jvedder/diff-probe/README.md

# Diff-Probe
A KiCAD PCB project for a differential scope probe.
 * 3db Bandwidth over 100 MHz (per LTspice)
 * Attenuation is 1:10 (that is, a '10x' probe)
 * Input range +72 V to -100 V 
 * Differential input range ±40 V for ±4 V output to scope
 * Power supply ±5 V

MIT License
