jvedder/diff-probe/diff-probe-bom.xlsx

Sheet: License
MIT License
Copyright (c) 2023 John Vedder
Permission is hereby granted, free of charge, to any person obtaining a copy
of this hardware, software, and associated documentation files (the "Product"),
to deal in the Product without restriction, including without limitation the
rights to use, copy, modify, merge, publish, distribute, sublicense, and/or
sell copies of the Product, and to permit persons to whom the Product is
furnished to do so, subject to the following conditions:
The above copyright notice and this permission notice shall be included in all
copies or substantial portions of the Product.
THE PRODUCT IS PROVIDED "AS IS", WITHOUT WARRANTY OF ANY KIND, EXPRESS OR
IMPLIED, INCLUDING BUT NOT LIMITED TO THE WARRANTIES OF MERCHANTABILITY,
FITNESS FOR A PARTICULAR PURPOSE AND NONINFRINGEMENT. IN NO EVENT SHALL THE
AUTHORS OR COPYRIGHT HOLDERS BE LIABLE FOR ANY CLAIM, DAMAGES OR OTHER
LIABILITY, WHETHER IN AN ACTION OF CONTRACT, TORT OR OTHERWISE, ARISING FROM,
OUT OF OR IN CONNECTION WITH THE PRODUCT OR THE USE OR OTHER DEALINGS IN THE
PRODUCT.

Sheet: diff-probe-bom
Differential Probe, 100MHz, ±40V
PCB 102 Rev A
MIT License
Ref Des | Qty | Value | Digikey PN | Buy? | Vendor | Vendor PN | Description | Cost Ea | Footprint
PCB | 1 | PCB | 3237-PCB_BARE_BOARD-ND | Y | Digi-key | PCB102_RevA | Printed Circuit Board via DKred | $5.140
C1, C3, | 2 | 3.3pF | 478-KGQ15ACG2D3R3BTCT-ND | Y | KYOCERA AVX | KGQ15ACG2D3R3BT | CAP CER 3.3PF ±0.1pF 200V NP0 0603 | $0.233 | Capacitor_SMD:C_0603_1608Metric
C2, C4, | 2 | 68pF | 478-KGQ15ACG2A680FTCT-ND | Y | KYOCERA AVX | KGQ15ACG2A680FT | CAP CER 68PF 100V NP0 0603 | $0.227 | Capacitor_SMD:C_0603_1608Metric
C5, C6, | 4 | 6.8pF | 478-KGQ15ACG2D6R8BTCT-ND | Y | KYOCERA AVX | KGQ15ACG2D6R8BT | CAP CER 6.8PF ±0.1pF 200V NP0 0603 | $0.321 | Capacitor_SMD:C_0603_1608Metric
C10, C11, C20, C21, C30, C31, | 6 | 1nF | 399-1082-1-ND | N | Kemet | C0603C102K5RACTU | CAP CER 1,000pF (1nF) 50V X7R 0603 | $0.032 | Capacitor_SMD:C_0603_1608Metric
C12, C13, C22, C23, C32, C33, | 6 | 10nF | 399-1091-1-ND | N | Kemet | C0603C103K5RACTU | CAP CER 10,000PF (10nF) 50V X7R 0603 | $0.038 | Capacitor_SMD:C_0603_1608Metric
C40, C41, | 2 | 1uF | 399-8147-1-ND | N | Kemet | C1206C105K5RACTU | CAP CER 1UF 50V X7R 1206 | $0.127 | Capacitor_SMD:C_1206_3216Metric
D1, D2, | 2 | BAT54W | BAT54WT1GOSCT-ND | Y | onsemi | BAT54WT1G | Schottky barrier diode, SOT-323 | $0.197 | Package_TO_SOT_SMD:SOT-323_SC-70_Handsoldering
D20, D21, | 2 | LED | 160-1435-1-ND | Y | Lite-on | LTST-C190KGKT | LED GREEN CLEAR CHIP SMD 0603 | $0.200 | Diode_SMD:D_0603_1608Metric
J1, | 1 | Conn_01x02 | 2057-PH1RB-02-UA-ND | Y | Adam Tech | Conn_01x02 | CONN HEADER R/A 2POS 2.54MM | $0.065 | Library:PinHeader_1x02_P2.54mm_Vertical
J2, | 1 | Conn_Coaxial | WM4089-ND | N | Molex | 73100-0167 | CONN BNC RCPT R/A 50 OHM PCB | $2.580 | Library:BNC_Molex_73100-0167_Horizontal
J3, | 1 | Conn_01x03 | 2057-PH1RB-03-UA-ND | Y | Adam Tech | PH1RB-03-UA | CONN HEADER R/A 3POS 2.54MM | $0.097 | Library:PinHeader_1x03_P2.54mm_Horizontal
R1, R3, | 2 | 191K 0.1% | YAG1553CT-ND | Y | YAGEO | RT0603BRD07191KL | RES SMD 191K OHM 0.1% 1/10W 0603 | $0.288 | Resistor_SMD:R_0603_1608Metric
R2, R4, | 2 | 10.0K 0.1% | YAG4438CT-ND | Y | YAGEO | RT0603BRB0710KL | RES SMD 10K OHM 0.1% 1/10W 0603 | $0.464 | Resistor_SMD:R_0603_1608Metric
R5, R7, | 2 | 1K 0.1% | YAG2179CT-ND | Y | YAGEO | RT0603BRB071KL | RES SMD 1K OHM 0.1% 1/10W 0603 | $0.464 | Resistor_SMD:R_0603_1608Metric
R6, | 1 | 2K 0.1% | YAG2183CT-ND | Y | YAGEO | RT0603BRB072KL | RES SMD 2K OHM 0.1% 1/10W 0603 | $0.468 | Resistor_SMD:R_0603_1608Metric
R8, R9, R10, R11, | 4 | 500 0.1% | 13-RT0603BRC07500RLCT-ND | Y | YAGEO | RT0603BRC07500RL | RES 500 OHM 0.1% 1/10W 0603 | $0.439 | Resistor_SMD:R_0603_1608Metric
R12, | 1 | 49.9 | YAG5744CT-ND | Y | YAGEO | RT0603FRE0749R9L | RES SMD 49.9 OHM 1% 1/10W 0603 | $0.059 | Resistor_SMD:R_0603_1608Metric
R20, R21, | 2 | 698 | 311-698HRCT-ND | Y | YAGEO | RC0603FR-07698RL | RES 698 OHM 1% 1/10W 0603 | $0.019 | Resistor_SMD:R_0603_1608Metric
U1, U2, U3, | 3 | LTC6228HS8 | 505-LTC6228HS8#PBF-ND | Y | Analog | LTC6228HS8#PBF | OpAmp, 730MHz, RRO, 500V/uS, 12V, 1-ch, SO-8 | $6.105 | Library:SO-8_3.9x4.9mm_P1.27mm
 |  |  |  |  |  |  | Cost Per Card | $34.62
Alternate Values
C1, C3, | 2 | 5.6pF | 478-KGQ15ACG2D5R6BTCT-ND | Y | KYOCERA AVX | KGQ15ACG2D5R6BT | CAP CER 5.6PF 200V NP0 0603 | $0.321 | Capacitor_SMD:C_0603_1608Metric
C2, C4, | 2 | 110pF | 399-C0603C111F5GAC7867CT-ND | Y | Kemet | C0603C111F5GAC7867 | CAP CER 110PF 50V NP0 0603 | $0.798 | Capacitor_SMD:C_0603_1608Metric
