jvedder/diff-probe/pdf/diff-probe-schematic.pdf

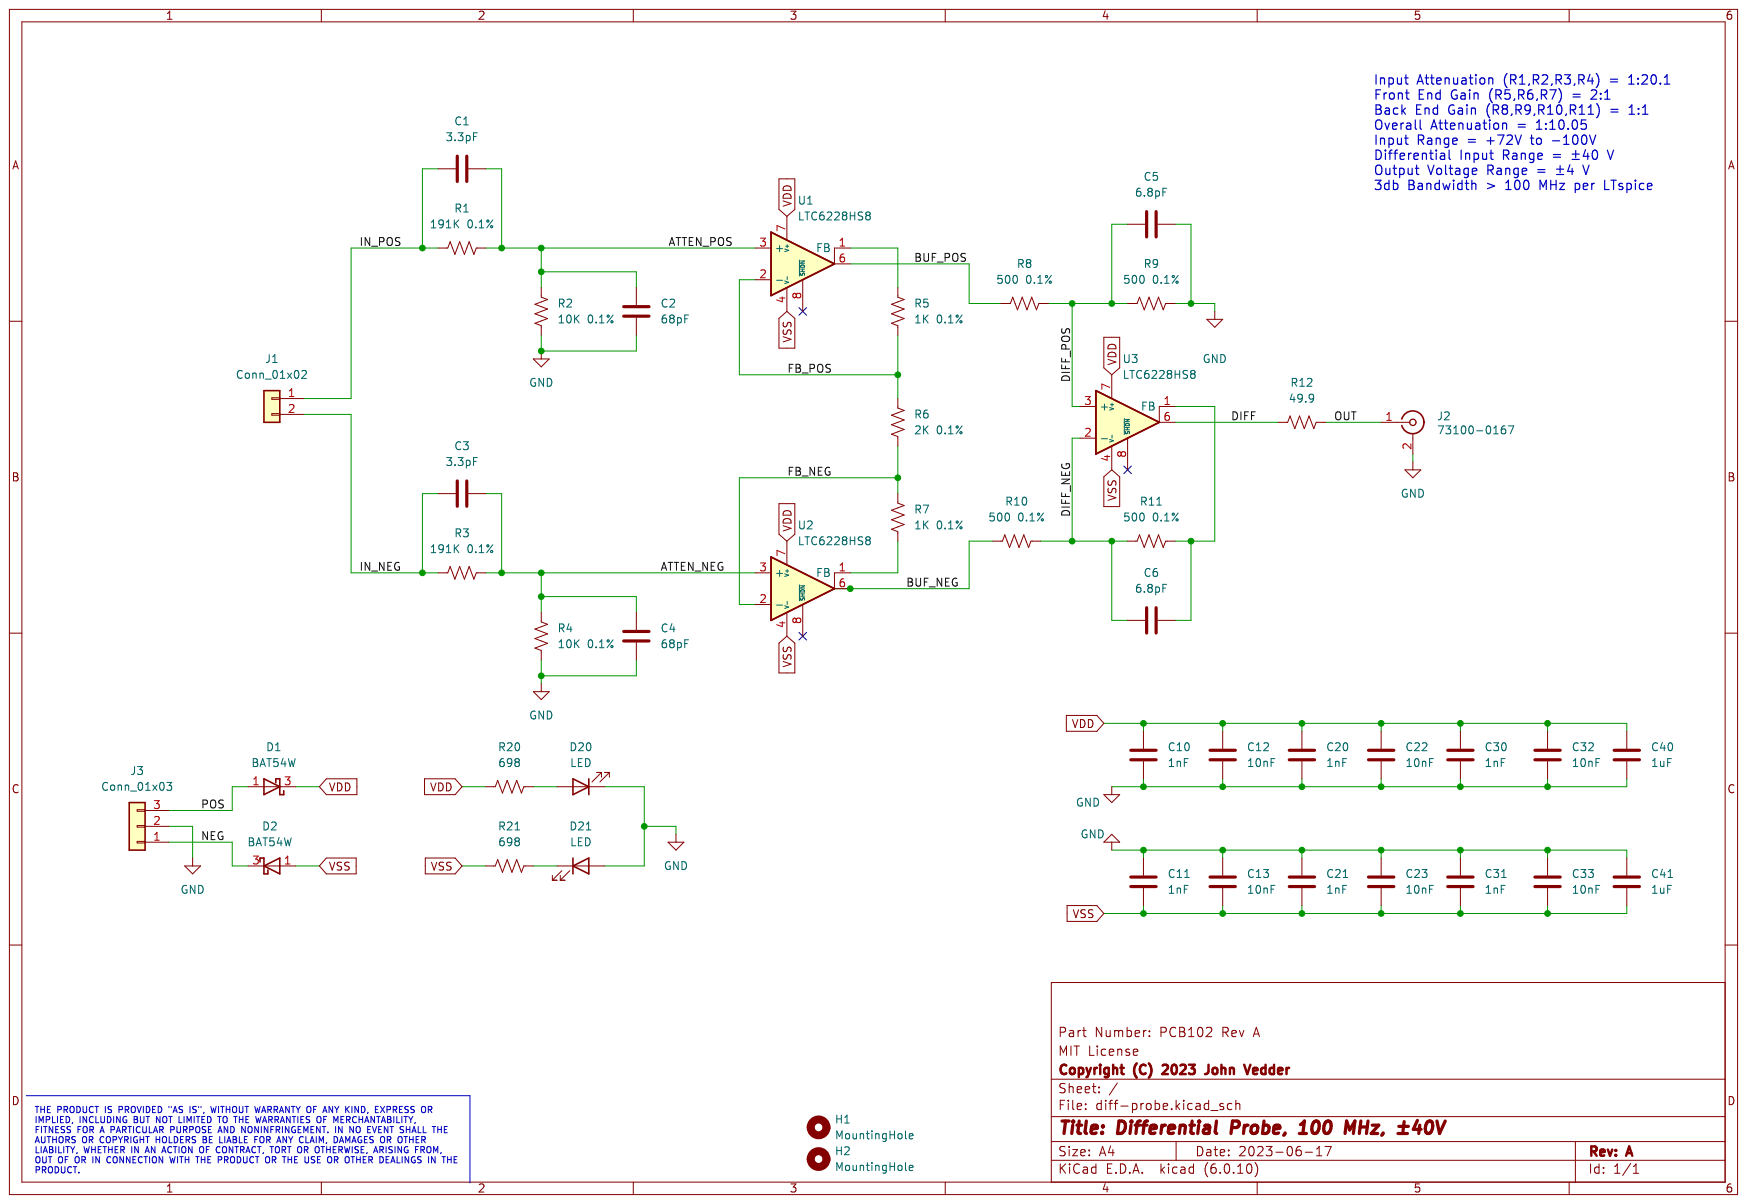
[picture p1: page 1]
