jvedder/diff-probe/pdf/diff-probe-fab-back.pdf

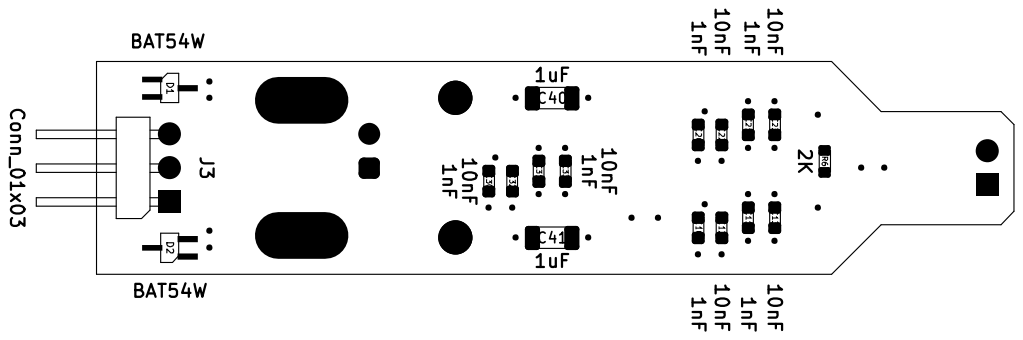
[picture p2: page 1]
