jvedder/diff-probe/pdf/diff-probe-fab-front.pdf

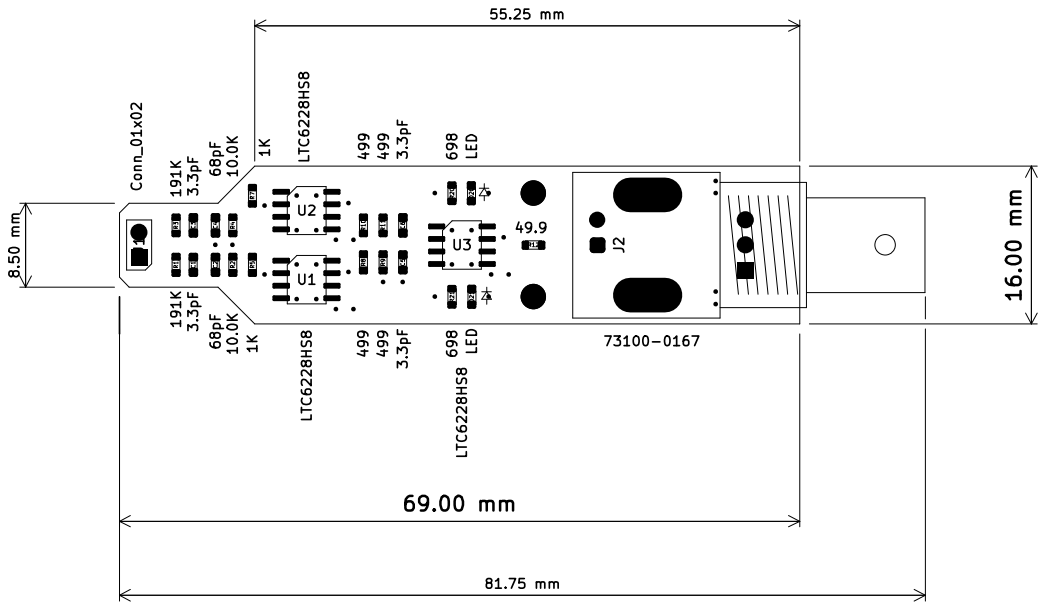
[picture p3: page 1]
