jvedder/diff-probe/LTspice/Diff Probe LTC6228 with Rc-Rd gain-AC.asc

C1: cap; {Ca}
C2: cap; {Cb}
C3: cap; {Ca}
C4: cap; {Cb}
C5: cap; {Ce}
C6: cap; {Cf}
C7: cap; {Ce}
C8: cap; {Cf}
C9: cap; {Cc}
C10: cap; {Cd}
C11: cap; {Cc}
C12: cap; 10nF
C13: cap; 10nF
C14: cap; 1nF
C15: cap; 1nF
C16: cap; 10nF
C17: cap; 10nF
C18: cap; 1nF
C19: cap; 1nF
C20: cap; 10nF
C21: cap; 10nF
C22: cap; 1nF
C23: cap; 1nF
Cout: cap; 25pF
D1: diode; BAV99HM
D2: diode; BAV199HM
D3: diode; BAV99HM
D4: diode; BAV199HM
D5: schottky; BAT54
D6: schottky; BAT54
R1: res; {Ra}
R2: res; {Rb}
R3: res; {Ra}
R4: res; {Rb}
R5: res; {Re}
R6: res; {Rf}
R7: res; {Re}
R8: res; {Rf}
R9: res; {Rc}
R10: res; {Rd}
R11: res; {Rc}
R12: res; 50
R90: res; 50
R91: res; 50
R_scope: res; 50
Rout: res; 10K
T1: tline; Td=5.090n Z0=53.5
U1: LTC6228
U2: LTC6228
U3: LTC6228
V3: voltage; 5V
V4: voltage; 5V
Vcm: voltage; {Vcm}
Vdiff: voltage; AC 1
Named nets: 0, VP, VN, V+5, V-5, OUT, BUF_N, BUF_P, Scope_P, Scope_N
.ac dec 100 1E3 2E9
.param Ra= 191K
.param Rb=10K
.param Rc= 1K
.param Rd=2K
.param Re=499
.param Rf=499
.param Vcm=0V
.param Ca=3.3pF; Alt is 5.6pF
.param Cb=68pF; Alt is 110pF
.param Cc=0pF
.param Cd=0pF
.param Ce=0pF
.param Cf=6.8pF
.param gain = {(Rb / (Ra+Rb) ) * (1+ 2*Rc/Rd) * (Rf/Re)}
.meas m_gain PARAM gain
.meas AC BW FIND freq WHEN mag( V(out)*10 )=sqrt(0.5)
.meas AC PH_AT_BW FIND ph( V(out)*10 ) WHEN mag( V(out)*10 )=sqrt(0.5)
.meas AC SCOPE_BW FIND freq WHEN mag( V(Scope_P,Scope_N)*10 )=sqrt(0.5)
.meas AC PEAK max  mag( V(out)*10 )
;.step param Ca  LIST 2.7pF 3.0pF 3.3pF
;.step param Cc  LIST 0pf 1pF
;.step param Cf  LIST 5.6pF 6.8pF
Input Attenuation (Ra,Rb) = 1:20
Front End Gain (Rc,Rd) = 2:1
Back End Gain (Re,Rf) = 1:1
Overall Attenuation = 1:10
Input Range = +72V to -100V
Differential Input Range = ±40 V 
Output Voltage Range = ±4 V
3db Bandwidth = 100 MHz
For RG-58 Coaxial Cable:
Zo = 53.5 ohm
C = 95.144 pF/m
so L = (Zo^2)* C = 272.33 nH/m
then Td = sqrt(L*C) = 5.090 nS
