jvedder/diff-probe/(commit log)

2023-04-23 Initial draft of schematic
    [diff-probe.kicad_pcb, diff-probe.kicad_sch]
2023-05-20 Updated schematics. Initial placement and early routing.
    [diff-probe.kicad_pcb, diff-probe.kicad_sch]
2023-05-21 Initial layout with SOIC op amp
    [diff-probe.kicad_pcb]
2023-05-28 Removed input diodes. Rerouted VDD and VSS.
    [diff-probe-soic.kicad_pcb, diff-probe-soic.kicad_sch]
2023-05-29 cleaned up power planes. Power connector on south edge. BNC connector is wrong footprint.
    [diff-probe-soic.kicad_pcb]
2023-05-30 Fixed BNC connector, Moved power connector to east edge on back side.
    [diff-probe-soic.kicad_pcb, diff-probe-soic.kicad_sch]
2023-06-03 Clean layout with SOT-323 schottky diodes and no LEDs
    [diff-probe-soic-B_Cu.gbr, diff-probe-soic-B_Mask.gbr, diff-probe-soic-B_Silkscreen.gbr, diff-probe-soic-Edge_Cuts.gbr, diff-probe-soic-F_Cu.gbr, diff-probe-soic-F_Mask.gbr, diff-probe-soic-F_Silkscreen.gbr, diff-probe-soic-In1_Cu.gbr]
2023-06-03 Fix pcb link to schematic
    [diff-probe.kicad_pcb]
2023-06-04 Added LEDs and moutning holes. Generated PDF drawing and gerbers.
    [diff-probe-B_Cu.gbr, diff-probe-B_Mask.gbr, diff-probe-B_Silkscreen.gbr, diff-probe-Edge_Cuts.gbr, diff-probe-F_Cu.gbr, diff-probe-F_Mask.gbr, diff-probe-F_Silkscreen.gbr, diff-probe-In1_Cu.gbr]
2023-06-05 Miscellaneous cleanup
    [diff-probe-B_Cu.gbr, diff-probe-B_Mask.gbr, diff-probe-B_Silkscreen.gbr, diff-probe-Edge_Cuts.gbr, diff-probe-F_Cu.gbr, diff-probe-F_Mask.gbr, diff-probe-F_Silkscreen.gbr, diff-probe-In1_Cu.gbr]
2023-06-05 rezip gerber files
2023-07-14 Update component values
    [diff-probe.kicad_pcb, diff-probe.kicad_sch]
2023-07-14 Add Bill of Materials
    [diff-probe-bom.xlsx]
